fabpsx/esphome-pitboss-850-advanced/Cheminement des signaux de contrôle de température.pdf

## Cheminement des signaux de contrôle pour le contrôle de la température du BBQ

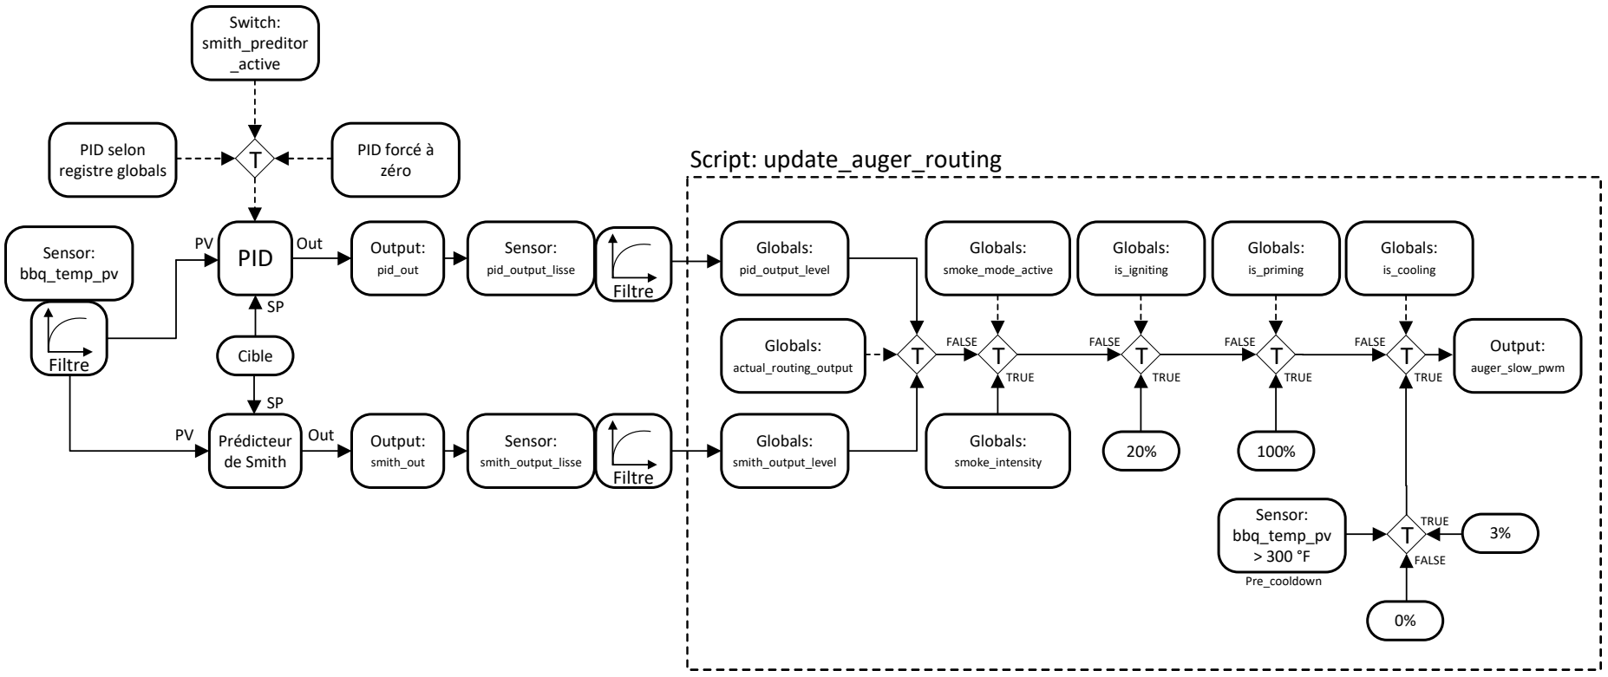
[picture p1: figure]
PID; Filtre; Prédicteur de Smith; Output:; pid_out; Sensor:; pid_output_lisse; smith_output_lisse; Globals:; pid_output_level; smith_output_level; smith_out; actual_routing_output; is_priming; is_igniting; smoke_mode_active; auger_slow_pwm T; smoke_intensity; Sensor: bbq_temp_pv; Cible; Out; Switch: smith_preditor _active; T PID selon registre globals; PID forcé à zéro; Script: update_auger_routing; Sensor: bbq_temp_pv > 300 °F; is_cooling; TRUE; FALSE; FALSE Pre_cooldown

Notes:
- Si l'interrupteur d’activation du Prédicteur de Smith est actif on force le P le I et le D à zéro pour désactiver le PID natif
- La sélection de la sortie à prendre pour le contrôle est fait dans le script: update_auger_routing
- Tout les calculs pour le Prédicteur de Smith se font dans le script: update_smith_output
