fabpsx/esphome-pitboss-850-advanced/Impression 3D/Couvercle Ventilation Cntrl BBQ Pitboss 850 Pro Serie.stl

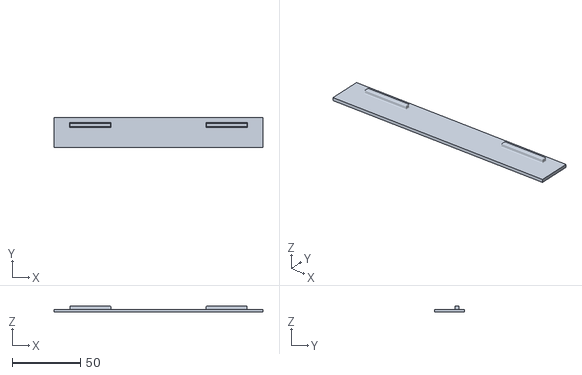
[picture p2: CAD file, 2026-10-22]
Impression 3D/Couvercle Ventilation Cntrl BBQ Pitboss 850 Pro Serie.stl
153.2 x 22.0 x 4.40
