fabpsx/esphome-pitboss-850-advanced/Impression 3D/Boitier Cntrl BBQ Pitboss 850 Pro Serie.stl

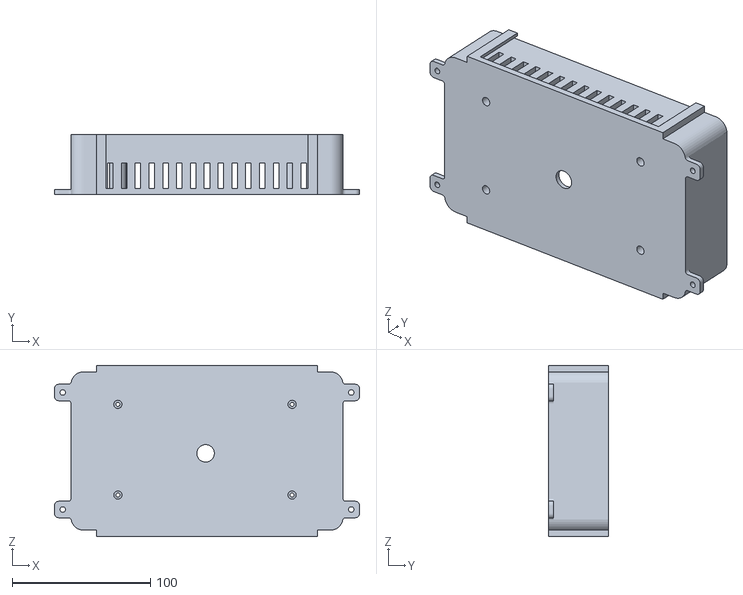
[picture p3: CAD file, 2026-10-22]
Impression 3D/Boitier Cntrl BBQ Pitboss 850 Pro Serie.stl
220.9 x 43.5 x 124.0
