fabpsx/esphome-pitboss-850-advanced/Diagramme de branchement.pdf

## 5VDC 5A

3V3

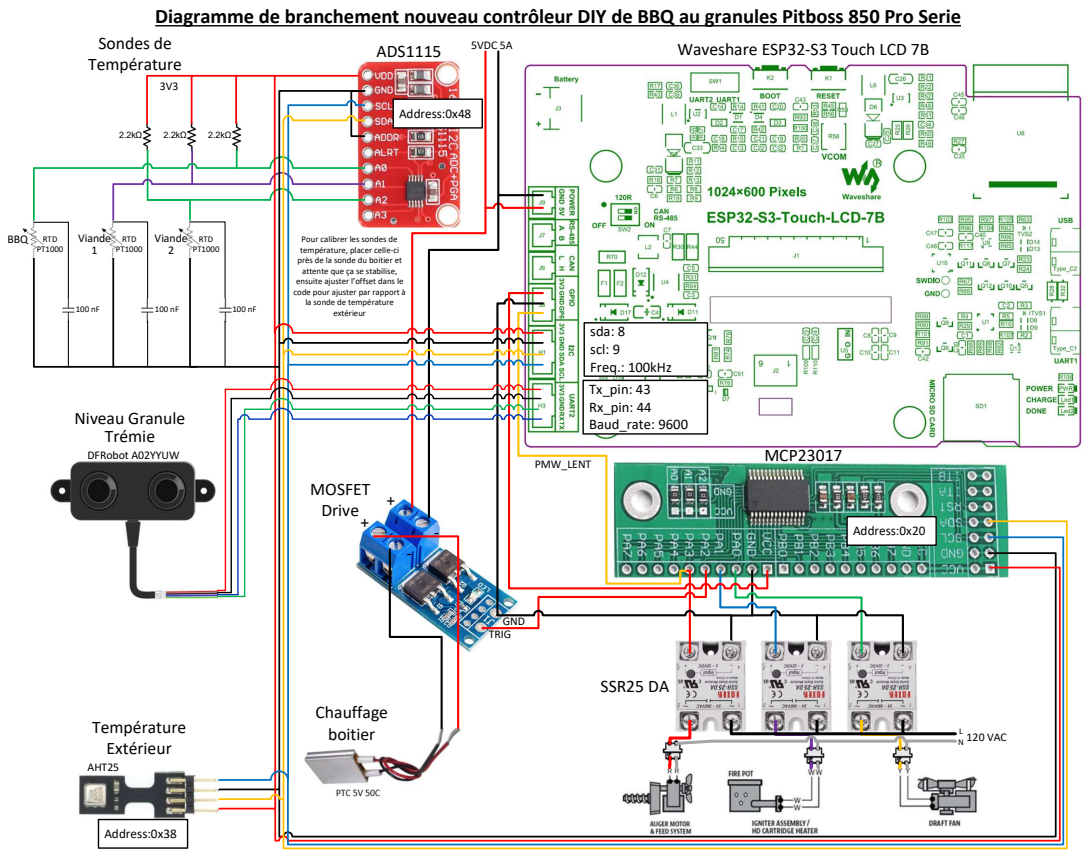
[picture p4: page 1]
- TRIG; GND; 120 VAC; Chauffage boitier; PMW_LENT; MCP23017; ADS1115; MOSFET Drive; SSR25 DA; sda: 8 scl: 9 Freq.: 100kHz; Address:0x48; Address:0x20; RTD; PT1000 BBQ; PT1000 Viande 1 RTD; PT1000 Viande 2; AHT25; Température Extérieur; Address:0x38; Niveau Granule Trémie; DFRobot A02YYUW; Tx_pin: 43 Rx_pin: 44 Baud_rate: 9600

Diagramme de branchement nouveau contrôleur DIY de BBQ au granules Pitboss 850 Pro Serie
Sondes de
Température

Waveshare ESP32-S3 Touch LCD 7B

Pour calibrer les sondes de température, placer celle-ci

près de la sonde du boitier et
attente que ça se stabilise,
ensuite ajuster l’offset dans le code pour ajuster par rapport à

la sonde de température extérieur
