fabpsx/esphome-pitboss-850-advanced/(commit log)

2026-10-22 Premier import
    [Boitier Cntrl BBQ Pitboss 850 Pro Serie.stl, Calcul de plage de mesure sonde RTD PT1000.xlsx, Calcul du % de niveau en volume de la trémie.xlsx, Couvercle Ventilation Cntrl BBQ Pitboss 850 Pro Serie.stl]
2026-10-22 Note d'archivage
    Ajout d'une section expliquant pourquoi le projet est archivé en mode lecture seule, tout en maintenant la licence et les conseils de calibration.
